MaPaFe/Drone/Arduino/AD5206_pins.jpg

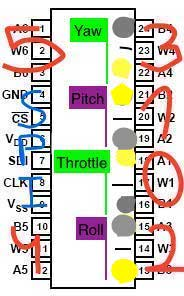
Arduino/AD5206_pins.jpg
