MaPaFe/Drone/README.md

# Drone
Programmabel drone freimwork

---

We decided to schwitch to C++ and gitlab: https://gitlab.com/MaPaFe/drone2
