MaPaFe/Drone/Langfassung 2017.pdf

## Inhaltsverzeichnis Kurzfassung

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
olle

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
alib

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
zisio

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
Digip

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
tisie

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
## Kurzfassung

Wir hatten uns eine günstige Spielzeugdrohne gekauft und nachdem wir etwas damit gespielt haben, ist uns aufgefallen, dass man deren Position ständig korrigieren muss, damit sie auf derselben Position bleibt. Wir fragten uns, ob ein Computer fähig wäre, die Kontrolle zu übernehmen und die Drohne selbstständig zu steuern. Um dies zu erreichen, mussten wir die Drohne zuerst im Raum orten, um sie dann von einem Computer aus zu kontrollieren. Die Erfassung der Drohne erreichten wir mit einer Kinect-Kamera, die nicht die Farbe eines Pixels ermittelt, sondern dessen Entfernung zur Kamera. Damit konnten wir die genaue Position der Drohne in 3 Dimensionen feststellen. Die Drohne wird mit einer kleinen Fernbedienung gesteuert, die die Position der Joysticks mittels Potentiometer misst. Um die Joysticks zu simulieren, benutzten wir einen Arduino als Steuereinheit mit einem digitalen Potentiometer. So haben wir die Drohne gesteuert, ohne die Joysticks bewegen zu müssen. Wir konnten damit die Drohne stabil in der Luft halten und gezielt Positionen im Raum anfliegen.

## Einleitung

Heutzutage sind Drohnen der Letzte Ruf, Firmen wie Amazon, Mercedes, Intel und Google investieren in Drohnenentwicklung. Doch alle haben als Ziel den Transport im Freien. Sie benutzen dafür große Drohne die viel wiegen und kraftvolle Motoren besitzen. Wir entgegen möchte eine Drohne für den Innenraum. Unser vorschlag ist einen System zu entwickeln, in dem der Raum die Drohne steuert. Der Raum soll dafür die Drohne orten können und dan . Das innovative ist hierbei, dass die Drohne nicht “denken” muss, sie hört nur “blind” zu was der Raum kommandiert. So erleichtern wir die Drohne, da diese keine Wahrnehmungstechnik tragen muss. Dass reduziert auch Strom verbrauch und steigert die Flugzeit.
Als Prototypsystem dachten wir uns die billigste Drohne zu kaufen, da diese am “blindesten” war (nur ein Sensor um waagerecht zu bleiben), und eine 3D-Kamera, die die Drohne dreidimensional orten konnte. Damit wollen wir auch zeigen, dass der System auch im schlimmstmöglichen fall funktioniert.
Es gibt Universitäten (z.B. ETH Zürich), die einen ähnlichen System benutze. Sie benutzen aber ein sehr teures VICON tracking System (mehrere zehntausende Euro). Was die ETH eigentlich forscht sind maniobrierungs Algorithmen und neue arten von Flugmaschine. Das “Endprodukt” ist nicht mit den Trackingsystem gedacht.
Dieses Projekt ist eine weiterleitung von “Externe Erweiterung der Fähigkeiten eines Spielzeugquadrokopters (Stabilisierung im Raum)”, welches wir im Wettbewerg Jugeng Forscht Iberia 2016 vorstellten.

## Materialien

Für unser Projekt brauchen wir manche Hardwarekomponenten, aber auch viele Softwarekomponenten, da es zum Teil ein Informatikprojekt ist.
Warum wir uns für genau diese Komponenten entschieden und wofür sie nötig sind, erklären wir im laufe der Arbeit.

Hardware:
Drohne: Cheerson CX-10
3D Kamera: Kinect 2
Mikrocontroller: Arduino Mega 2560 Potentiometer: AD5206
Software:
Processing
Serial Bibliothek
Blob detection Bibliothek
Kinect Bibliothek
Mac version
Windows version
Arduino
SPI Bibliothek

## Durchführung

Unser Projekt ist in zwei Teilen unterteilbar: zum Ersten müssen wir die Drohne vom Computer aus kontrollieren, aber als Zweites auch deren Position bestimmen um entscheiden zu können, wie sie sich bewegen muss.

Öffnen der Fernbedienung

Am Anfang haben wir gedacht, dass wir die Radiosignale, die von der Fernbedienung zur Drohne gesendet werden, aufnehmen können um die verschiedenen Kommandos (zum Beispiel wie stark nach vorne zu bewegen), zu verstehen um diese später beliebig selber zu senden und die Drohne damit steuern.

Als wir aber die Fernbedienung öffneten und herausfanden, dass deren Joysticks, wie in in vielen anderen Modellen auch, mit simplen Potentiometern funktioniert, dachten wir uns, dass es eine viel bessere Idee wäre, einfach diese

Potentiometer zu simulieren und so der Fernbedienung denken lassen, dass man die Joysticks physisch bewegt.

Dies erreichten wir mit hilfe eines digitalen Potentiometers. Dies ist eine Art von IC (integrated circuit) welches digitalen Signalen zu einem analogen Widerstand wandelt.

Diese Technik besitzt mehrere Vorteile, doch vor allem, dass jedes Drohne Modell höchstwahrscheinlich andere Signale für dieselben Bewegungen benutzt. In diesem Fall wäre es nötig, für jede einzelne Drohne das ganze Prozess zu wiederholen, um sie fliegen zu können, welches nicht das Ziel des Projektes ist. Außerdem ist die Messung dieser Signale auch nicht trivial, da wir spezialisierte Hardware und eine erweiterte Verständigung der Kommunikationsprotokolle bräuchten.

Die Funktionsweise eines digitalen Potentiometer sind kleine Widerstände innerhalb des Chips, die mit Transistoren in Reihe zusammengeschaltet werden, um einen größeren Widerstand zu bilden.

Wir entschieden uns für den AD5206 als digitaler Potentiometer (kurz Digipot) wegen den folgenden zwei Gründen: es ist ein einziges Chip mit 6 Digipots, womit der elektronische Schaltkreis simpler bleibt und es benutzt SPI als Kommunikationsprotokoll, weshalb es sehr einfach mit einem Mikrocontroller zu benutzen ist.

Mikrocontroller

Es fehlt nur noch ein Bauteil,der Mikrocontroller, welches die Befehle des Computers auf das Digipot weiterleitet, da der Computer selber nicht SPI “sprechen” kann. Der Mikrocontroller wird wie ein Übersetzer benutzt, dank ihm können der Computer und der Digipot kommunizieren. Als Mikrocontroller haben wir ein Arduino Mega mega ausgesucht, da dieser einfach zu programmieren ist. Arduino ist eine open source Hardware/Software initiative, die die Vereinfachung der Benutzung Mikrocontroller strebt. Der Arduino Mega spricht mit den Computer durch einen internen seriellen Port durch eine USB verbindung. Der Arduino kann nicht nur SPI, es kann auch programmiert werden. Darum benutzen wir es auch um die Verbindung mit der Drohne zu automatisieren (wird später aufgegriffen).

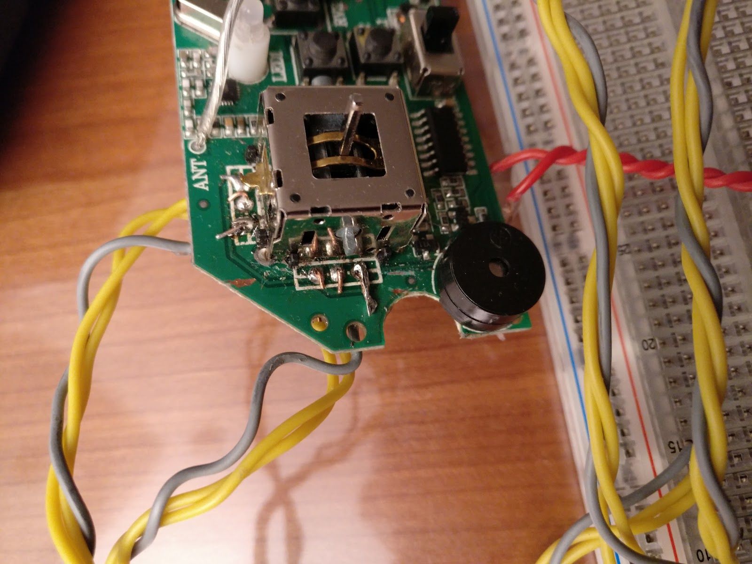
[picture p2: figure]

Um die Fernbedienung zu dem Digipot anzuschließen mussten wir zuerst die “normalen” Potentiometer auslöten. Es stellte sich heraus, dass der benutzte Lötzinn ein industrieller war und sich deshalb von unseren einfachen Lötkolbe in der Schule nicht löten ließen, weshalb wir die Joysticks rausreißen mussten.

Danach mussten wir nur noch drei Kabel per Potentiometer von der Fernbedienung zum Digipot und diesen wiederum zum Arduino verbinden.

Jetzt kann der Computer beliebig die Drohne steuern, aber damit sie sich komplett autonom bewegen kann, muss der Computer auch wissen, wo die Drohne ist um die gewünschten Anweisungen für die Fernbedienung zu rechnen.

Kinect

Als erstes brauchten wir eine 3D-Kamera, das ist eine Kamera die anstatt die Farbe von einem Pixel messen kann, die Distanz zu diesem Punkt ermittelt. Wir brauchen so eine Kamera um wissen zu können, wo genau sich die Drohne im 3D-Raum befindet. Außerdem ist es damit im Gegensatz zu einer “normalen” Farbkamera einfacher den Quadrokopter vom Hintergrund zu differenzieren.Wir entschieden uns unter den vielen Modellen für die Kinect für mehrere Gründe. Es ist mit 170€ eine der günstigsten Kameras überhaupt und hat eine sehr präzise theoretische Auflösung von 2 Millimetern in der Tiefe.Die Kinect wurde eigentlich von Microsoft für die XBOX Spielkonsolen entwickelt, kann aber mit einigen Adapterkabeln auch mit einem Computer benutzt werden.
Die Funktionsweise der Kinect ist ähnlich eines radar system, doch anstatt niedrige Frequenz Photonen benutzt es hoch Frequenz Photonen, also Licht. Darum werden Kameras, die mit diesem Prinzip funktionieren, auch LIDAR genannt (light-radar). Als Sendere werden drei infrarot Leds benutzt und als Empfänger wird ein spezieller Time-of-flight (Tof) sensor eingesetzt. Dieser misst die Zeitverschiebung zwischen dem Senden und Empfangen mithilfe spezieller Pixels. Mit dieser Zeitverschiebung kann die Distanz berechnet werden, dar
c = | t , die halbierung der Zeit ist nötig, da | eigentlich die kombinierte

l
t
2

1 ⇒ l = c * 2

1
t | t

identische Hin- und Zurückzeit ist. Das gesendete Signal ist Licht und bewegt sich darum mit Lichtgeschwindigkeit c = 299 792 458 m .
Der Sensor wurde von Microsoft selbst entwickelt und besitzt ein Auflösung von 512 mal 424 pixel (0,217 Megapixel). Der Sensor kann auch per Pixel den Infrarot Umgebungslicht des Raumes, die der Sonnenlicht enthält, berücksichtigen. Die reichweite des sensors ist von den Leds limitiert, diese bieten aber dafür einen breiten Beleuchtungsraum.

Datenerfassung

Die Kinect gib aus Output einen eindimensionalen Array d i die die Distanzen in Millimetern enthält. Obwohl der Sensor eigentlich bidimensional ist werden die Daten in ein einzigen Array gefasst, da dieses effizienter ist. Durch der benutzung dieser Speichermethode verliert sich aber die Intuition eines bidimensionalen Array in den zwei Indexen die Position des Pixel Bestimmen. Doch die eindimensionaler Array ist eigentlich nur die aneinanderreihung der Zeilen

des Sensors: di = dzeile 1 + dzeile 2 + ... + dzeilen n

. Mit hilfe der Formel di,j | kann sie als eine

bi. = d

uni.
i+B j *
bidimensionale gelesen werden. Hierbei ist i und j die zwei indexe und B der máximaler i

Wert. Im falle der Kinect würde i die X-Achse des Sensors sein, j die Y-Achse und B würde den Wert 512 entsprechen.

Pespektivkorrektur

Jetzt muss man aber bedenken, dass die Kinect eine Kamera ist und darum seine Daten Perspektive beinhalten. Um diese Perspektive zurückzurechnen benutzt man den
Punktkamerapespektivenmomdell (Fig.1): (− p | ) | . Hierbei ist | der

p
x,y − Mx,y = p
r
z

f x,y
* p

r
x,y | p

p
projektierter Punkt auf der Projektionsebene (Sensor), p der reelle Punkt im Raum, ist die

r
f x,y
Brennweite und Mx,y die optische Mitte.

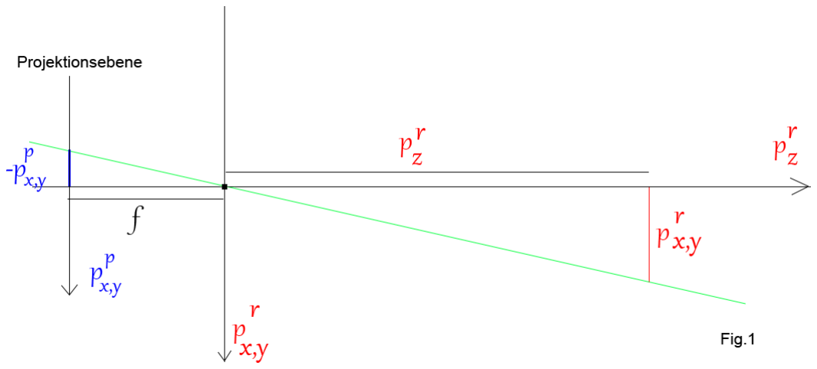
[picture p3: figure]

In einer normalen kamera ist p bekannt aber | nicht. Dies ist so dar | und | unbekannt sind
p | p
r | pz | p

r
x,y
( f x,y

ist eine optische eigenschaft der kamera, mathematisch gesehen eine Konstante). Doch in
der Kinect ist p bekannt und | kann mit einfachen umformen mit der Formel
z | p

r
x,y
(− p | ) | berechnet werden.

p
x,y − Mx,y *

p

r
z
f x,y

= p

r
x,y

Kalibrierung

Ein wichtiger Aspekt wenn man mit Kameras arbeitet ist ihre Kalibrierung. Dabei werden die Brennweite f und die optische Mitte des Sensors gesucht. Wir benutzten den Programm GML C++ Camera Calibration Toolbox (http://graphics.cs.msu.ru/en/node/909) von der Graphics and Media Lab an der Staatlichen Universität Lomonosov in Moskau. Das programm nimmt Fotos von Kalibrierungsmustern und berechnet von ihnen die nötige Parametern. Unsere Gab für die Brennweite f x = 364.18 f y = 364.33 und für die
optische Mitte ergab sich die geometrische Mitte also Mx,y = | ( | ist 2
maxx,y | max
der Maximalwert für x oder y , also die breite und höhe des sensors).

Präzision der Kinect

Wie schon erwähnt wurde, misst die Kinect Distanzen durch reflexion von Licht. Das führt manchmal zu Fehlmessungen in reflektiven gegenstände, da das Licht nur dann gelesen werden wenn es den Sensor auch erreicht. Ein anderer problem sind dunkle Gegenstände, da diese Photonen teilweise absorbieren. Das hat zur folge, dass weniger Photonen den Sensor erreichen und die messung mehr Rauschen enthält. Noch ein Problem ist die Lichtquelle die den Raum nicht gleichmäßig beleuchtet und bestrahlen den Bildrand kaum. Wir haben auch die durchschnittliche Abweichung jedes Pixel berechnet. Dafür haben wir den für jeden Pixel d ,
i | n
Messungen durchgeführt und in di gespeichert. Mit der Forme | kann
j

### di = n

1
* ∑

n

j=1

d d

i
j

− m i

dann die durchschnittliche Abweichung berechnet werden. Wobei der durchschnitt des Pixel
md mit der Formel | bestimmt wird. Der Resultat kann in einem Foto dan i | mdi = n

1
* ∑

n

j=1

di
j
visualisiert werden. Hierbei ist : orange ≈ 1,27mm,
gelb ≈ 2,8mm,
grün ≈ 5 mm,
blau ≈ 10mm und
rot ≈ 16mm.
Ab 16mm sind die Pixels Schwarz gezeigt. Die Ränder aber besonder die Ecken haben ein sehr hoher Rauschen. Die größte Fläche hat aber ein geringes rauschen mit nur 1.3mm Abweichung.

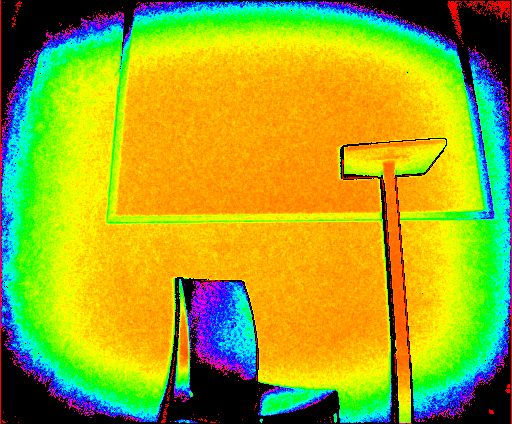
[picture p4: figure]

Programmierumgebung

Als Programmierumgebung entschieden wir uns für Processing, eine auf Java basierte Sprache die für uns die meisten Vorteile hat. Wir haben bereits mehrere Jahre damit Erfahrung und sie besitzt die nötige Bibliotheken für die serielle Kommunikation mit Arduino und die Kommunikation mit der Kinect. Es ist außerdem open-source und cross-platform, was heisst, dass es auf jedem Operativsystem funktioniert.
Die Entfernungswerte der Kinect werden mithilfe einer Bibliothek erfasst. Diese Bibliothek ist jedoch für Mac und Windows eine andere, deshalb während die Methodenname im Programm anders weshalb wir den gleichen Code nicht in verschiedenen Computern benutzen könnten. Um dies zu tun, schrieben wir zwei Wrapper-Klassen, eine für jede Plattform, die die gleichen Methodennamen benutzt, damit der Programmiercode austauschbar ist. Außerdem schrieben wir noch eine dieser Klassen, die ein vorher aufgenommenes Video von der Kinect abspielt, damit wir Programme austesten können, wenn wir nicht die Kinect dabei haben oder die physische Umgebung nicht die richtige ist.
Die eigentliche Erfassung der Position funktioniert in mehreren Schritten, es benutzt also verschiedene Algorithmen je nach Zustand des Programmes.

Finden der Drohne

Am Anfang, wenn die Drohne noch nicht gefunden wurde wird das die Drohne mit des sogenannten Mindestabstand erfasst. Mit dieser Methode wird alles, was näher als ein vorbestimmter Wert ist, als Drohne erkannt. Diese Mindestdistanz muss klein genug sein, dass der Hintergrund nicht erfasst wird und für die Drohne verwechselt wird. Die Drohne wird näher zur Kamera gebracht, bis sie vom System erkannt wird und mit diesem Erstwert zu der nächsten Erkennungsmethode schreitet.

Blob detection

Blob detection (BD) ist ein Algorithmus im Bereich des computer vision welches Gruppen von Pixeln in einem Foto, die zum selben Objekt gehören erkennen kann. Dies funktioniert in einem üblichen Farbbild indem man alle Pixel die eine ähnliche Farbe haben und nah zueinander sind zusammen gruppiert.

Finden am Anfang

Wir können diese Methode benutzen um die Position der Drohne im Bild der Kinect zu finden. Dafür erstellen wir ein eigenes Bild mit weißem Hintergrund auf welches wir nur die Pixel färben, die Teil der Drohne sein könnten um auf dieses Bild BD auszuführen und die mittlere Position der Drohne zu bestimmen. In dem ersten Teil unseres Systems wären diese gefärbten Pixel genau die, deren Distanz zur Kamera kleiner als ein bestimmter Wert ist.
Um die Drohne danach weiter lokalisieren zu können, benutzen wir eine Reihe verschiedener Algorithmen, unter anderem auch unser selbstentwickeltes Box-tracking.

Box-tracking

Um den aktuelle Standort der Drohne zu bestimmen, berechnen wir zuerst die vorhergesehene nächste Position mithilfe der vorherigen zwei. Wir subtrahieren also die vorletzte Position von der letzten um die Geschwindigkeit zu bekommen und addieren diese letztendlich zur letzten Position. Jetzt haben wir eine Vorhersage von dem Ort, an dem sich die Drohne höchstwahrscheinlich befindet, welche dem Box-tracking als input gegeben wird.
Wie dieses Algorithmus funktioniert, kann man sich einfach vorstellen: Um die Vorhersage, also den Punkt im dreidimensionalen Raum, zeichnet man eine Kiste, und alle Objekte, die sich innerhalb dieser Kiste befinden, werden als Drohne erkannt. Ist in dieser Kiste gar nichts zu

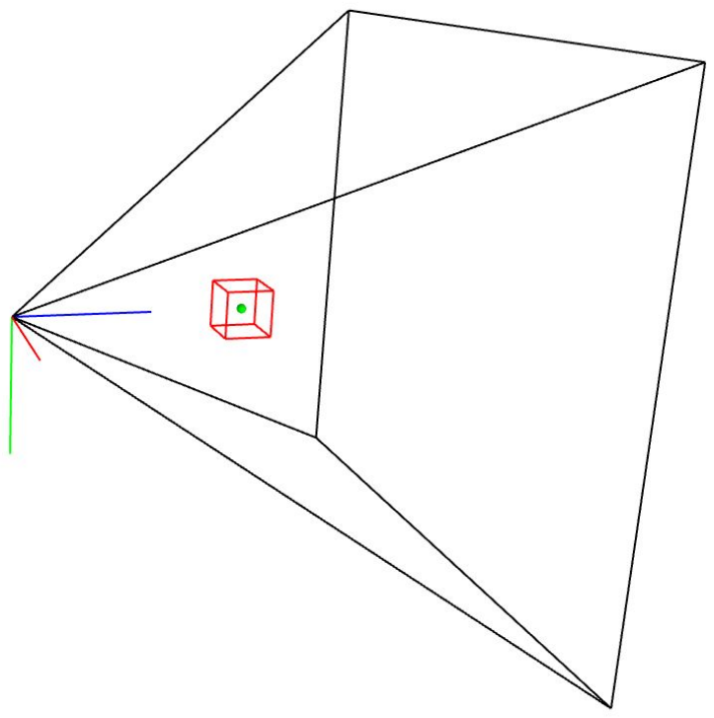
[picture p5: figure]

finden, wird deren Größe ein Stück erweitert, und das solange bis etwas gefunden wurde oder sie zu groß ist, in diesem Fall wird die Drohne als verloren angesehen und es wird von neuem angefangen.
In der Praxis wird nur über die Werte im Array der Kinect iterieriert, die sich in der Kiste befinden, und davon werden nur die Werte, die in der z-Achse auch innerhalb der Kiste sind, auf das neue Bild für das BD übertragen.
Nun können wir zuverlässigerweise die Drohne im Raum orten, doch um sie zu steuern, müssen wir auch berechnen, wie sich die Joysticks bewegen müssen, damit die Drohne zu dem gewünschten Punkt fliegt.

Berechnung der Potentiometer

Um dies zu erreichen, benutzen wir einen sogenannten PID-Regler. Das ist ein Algorithmus für die Regelung von Werten, die man nicht direkt ändern kann und vielleicht Störungen von außen haben (z.B. Wind, Stöße). Eine Praktische Anwendung dafür wäre ein autonomes Fahrzeug, welches das Gaspedal des Autos steuern (also die Beschleunigung v ) kann, aber nicht die genaue Position (s). Deshalb muss es die Beschleunigung immer weiter ändert bis die aktuelle Position der gewünschten (Setpoint) entspricht.Für unsere Drohne hat jede Achse einen eigenen PID, welcher mit der aktuellen Position der Drohne und dem Setpoint informiert wird und den Widerstandswert für den Digipot berechnet.
Der PID Reglungsalgorithmus besteht aus drei verschiedene Teile, die versuchen ein Fehler zu minimieren. Das P teil steht für Proportional zum Fehler, I für die Integral des Fehlers mit der

Zeit und D für Derivativ (in deutsch Ableitung), die momentane änderung des Fehlers. Diese Teile werden zusammen addiert und die resultierende Summe ist die die nötige Korrektur. Hierbei ist jeder Teil gewichtet um mehr oder weniger anteil in der finalen Summe zu haben. Die

PID Formel lautet PID = Kp * F(t) + K | (t) dt | . Mit den Gewichten | , , | .

i * ∫

t

0

| F + Kd * dt
dF(t) | Kp Ki Kd

Bei der Implementation ist die berechnung des PIDs einfach, dar der proportionale Teil eine einfache Multiplikation ist, der Integrale Teil ist eine Variable die den Fehler addiert bekommt und so den kumulativen Fehler beinhaltet und Derivative Teil ist die differenz des Letzten Wertes und den neusten.
Das komplizierte an den PID sind die korrekte Gewichten zu finden. Diese sind nur experimentell zu bestimmen. Das hat uns viel Zeit gekostet, da bei einer Drohne alle drei PIDs gleichzeitig bestimmt werden müssen.

Processing zu Arduino

Um die berechneten Werte letztendlich wieder zur Fernbedienung über zu senden, kommunizieren wir zuerst mit dem Arduino mit dem seriellen Port über USB. Es gibt für Processing eine leicht zu benutzende Bibliothek, die fast alles automatisch macht. Da alles im Processing-programm berechnet wird, werden nur die endgültigen Werte, die auf den Digipot weitergeleitet werden, gesendet. Diese Werte sind ein Array mit vier Variablen des Typs byte, da die Potentiometer nur 255 verschiedene Positionen haben können. Wir versuchen die kleinste Anzahl an Daten zu senden damit sie schneller übertragen werden.
Im Arduino wird dieses Array empfangen und die Werte einfach auf den Digipot kopiert. Danach wird ein einziges byte zurückgesendet welches Processing wissen lässt, dass der Arduino bereit ist, die nächsten Werte zu empfangen.

Arduino zu Digipot

Die Kommunikation mit dem Digipot wird mit SPI realisiert. SPI ist ein Kommunikationsprotokoll, welches mit nur drei Kabeln funktioniert und mehrere verschiedene Endgeräte (in unserem Fall mehrere digitale Potentiometer), auch als “Sklaven” bezeichnet, auf einmal unterstützt, welches für uns nützlich ist wenn wir mehrere Drohnen fliegen wollen, weil wir einfach ein zweites Digipot anschließen müssen und schon funktioniert. Um mit dem AD5206 einen Widerstand zu stellen stellt man den “Sklavenauswahlpin” auf 0 Volt, um dem Protokoll wissen zu lassen, an welches der Sklaven die Werte zu senden sind. Mit unserem aktuellen Aufbau gibt es nur ein Digipot, aber dieser Schritt ist wichtig, wenn man mit mehreren Sklaven arbeitet. Danach werden mit der SPI Bibliothek zwei Werte gesendet (mit einem

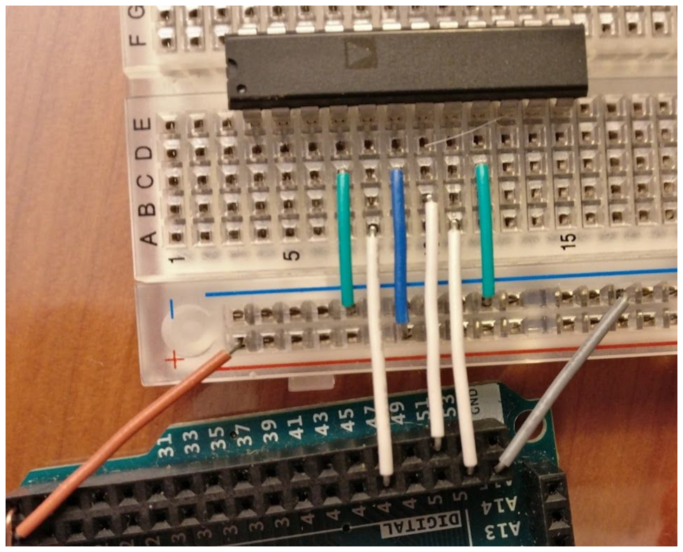
[picture p6: figure]

anderen Modell als der AD5206 funktioniert dieser Schritt vielleicht anders): zuerst eine Zahl von 0 - 5, welches den einzelnen simulierten Potentiometer (da es im selben Chip sechs gibt)

auswählt und danach den Widerstandswert von 0 - 255 welcher dieser Potentiometer haben sollte. Dieser Wert wird dann auf Ohm umgewandelt, in unserem Fall also von 0 Ω - 10k Ω .

Automatisierung der Verbindung

Nach mehreren Flügen ist uns aufgefallen, wie zeitverschwendend es ist, die Drohne am Anfang mit der Fernbedienung zu verbinden, denn um das zu tun, muss man den linken Joystick zuerst ganz nach unten bewegen, dann ganz nach oben und zuletzt wieder nach unten. Das wird “Arming” genannt.
Dies ist dafür gedacht, dass die Fernbedienung weiß, welche die Maximal- und Minimalwerte dieses Joysticks sind,also sich eicheln.
Nach jedem dieser Schritte piepst ein kleiner Lautsprecher und wir dachten uns, dass wir diesen ganzen Prozess automatisieren könnten indem der Arduino sozusagen “hört” wann es piepst und entsprechend dazu die ausgehenden Werte anpasst, damit es nur noch nötig ist, Arduino, Fernbedienung und Drohne einzuschalten und das “Arming” automatisch vorgeht.

Dafür mussten wir noch ein Kabel von dem Piepser zum Arduino löten, der dann die Stromspannung misst und damit, ob der Piepser gerade an ist oder nicht.

Open-source

Alle unsere geschriebenen Programme sind open source und auf GitHub unter der Adresse https://github.com/MaPaFe/Drone erhältlich. Es ist mit der Mozilla Public License 2.0 lizensiert, was heisst, das jeder erlaubt ist, den Code zu sehen und sogar selbst zu benutzen und erweitern, solange wir dafür Anerkennung bekommen und Patentrechte behalten.

Messungen

Um unser System zu werten brauchen wir Messungen zu machen. Eine erste, logische, Messung ist die Drohne auf einen Punkt im Raum Kommandieren und n Messungen der echten Drohn Position durchführen. Nun kann man die durchschnittliche Abweichung rechnen:
ax = | . Wobei die rechnung für jede Achse separat geführt wird und | die Achse n

1
* ∑

n

i=1

x

i − mx

x

bezeichnet und mx der durchschnitt der Werte ( mx = | ). Nun hat man einen Wert für jede n

1
* ∑

n

i=1

xi

Achse, den man mit anderen Systeme vergleichen kann. Man kann dann auch den wert der drei Achsen in einem zusammenfassen: as = . Diese Rechnung kann mit ein bisschen 3

ax+ay+az
modifikation auch um die genauigkeit der Drohne beim Pfad Folgen benutzt werden. Anstatt den wert gegen den der Durchschnitt zu vergleichen, wird er gegen die theoretisch korrekte
Position vergleicht: ax = | . Bedenkt werden ist, dass beim generieren der korrekten n

1
* ∑

n

i=1

x

i − Ti

positionen T auch die geschwindichkeit geprägt wird. Dadurch kann auch die geschwindichkeit
i
gegen Präzision untersucht werden um die optimale geschwindigkeit zu suchen.

## Mögliche Anwendung

Wir wollten dieses System bauen, um die Drohne von einem aus Computer kontrollierbar zu machen und so zu automatisieren.
Dies könnte industrielle Anwendungen haben wie zum Beispiel im Gütertransport in Innenräumen. Wie kann eine Firma eine Drohne als Transportmittel im selben Firmengebäude benutzen, um z.B. Schrauben zu transportieren und dafür nicht ein eigenes Fließband bauen zu müssen? Eine Drohne könnte diese Arbeit verrichten. Sie kann mit sehr wenig Aufwand neue Wege gehen und flexibel neue Aufgaben verrichten.
Doch Drohnen haben ein Nachteil, sie können nur entsprechend ihrer Größe Nutzlast transportieren. Größere und darum schwere Drohnen könnten zu Problemen führen, da sie sehr unkontrolliert und in geschlossenen Räumen fliegen und große Motoren starke Turbulenzen erzeugen. Darum sollte eine indoor-Drohne klein sein und wenig wiegen. Da kommt unser System ins Spiel. Es macht die Drohne sehr leicht, weil die Wahrnehmungssensoren nicht von der Drohne selber getragen werden müssen. So können Drohnen ihre Motorkraft benutzen um die Nutzlast zu tragen, anstatt der zusätzlichen Sensoren.
Man muss auch berücksichtigen, dass die Sensoren und die Datenverarbeitung Energie verbrauchen und damit die Flugzeit verkürzen würden und um diese zu halten müsste man eine größere Batterie benutzen, die wiederum die Drohne schwerer mache würde und sie bräuchte dann stärkere Motoren. Diese wiegen mehr und verbrauchen mehr Strom und man braucht ebenfalls eine größere Batterie. Dieses Prozesse können einfach mit unserem System gestoppt werden.
Das System hat auch Vorteile beim hochskalieren, da die externen Sensoren für mehrere Drohnen genutzt werden können. Dies würde ebenfalls die Kosten vermindern. Je mehr Drohnen man kauft, umso besser ist das Preis-/Leistungsverhältnis des Systems.

## Pläne für die Zukunft

Wir haben viele geplante möglichen Erweiterungen für die Zukunft geplant. Als Erstes würden wir weiter die PIDs kalibrieren, damit die Drohne stabiler fliegt.
Darüber hinaus wäre es dank unser Box-tracking keine große Herausforderung, zwei oder mehr Drohnen gleichzeitig fliegen zu lassen. Danach könnten wir mehrere Kinect Kameras anschließen, um ein größeres Sichtfeld zu haben auf dem mehr und größere Drohnen passen würden.
Eine Limitierung von unserem Aufbau ist, dass die Drohne in einer bestimmten Ausrichtung sein muss, um zu funktionieren: nach vorne. Wenn die Drohne aber z.B. 90º nach rechts gedreht ist und den Befehl bekommt, sich nach vorne zu bewegen, würde sie nach rechts gehen, die PID-Regler versuchen diese Abweichung zu korrigieren, aber dies macht sie nur größer. Wir könnten einen Algorithmus schreiben, welches diese Drehung erkennt und korrigiert.

## Quellen

Arduino Mega 2560 datasheet 6.11.17
https://store.arduino.cc/arduino-mega-2560-rev3
AD5206 datasheet 6.11.17
http://www.analog.com/en/products/digital-to-analog-converters/digital-potentiometers/ad5206.h tml (http://www.analog.com/en/products/digital-to-analog-converters/digital-potentiometers/ad5206.html)

Processing homepage 7.11.17
https://www.processing.org/
Serial Bibliothek Referenz 8.11.17 https://www.processing.org/reference/libraries/serial/ Blob detection Bibliothek Referenz 8.11.17 http://www.v3ga.net/processing/BlobDetection/ Kinect Bibliothek für Mac Tutorial 7.11.17 http://shiffman.net/p5/kinect/
Kinect Bibliothek für Mac Quellcode 7.11.17 https://github.com/shiffman/OpenKinect-for-Processing Kinect Bibliothek für Windows Referenz 8.11.17 http://codigogenerativo.com/kinectpv2/
Arduino homepage 6.11.17
https://www.arduino.cc/
Arduino SPI Bibliothek Referenz 6.11.17 https://www.arduino.cc/en/Reference/SPI

Kinect offizielle Dokumentation 12.11.17 ttps://msdn.microsoft.com/en-us/library/windowspreview.kinect.depthframe.aspx
Kinect Perspektivkorrektur Tutorial 11.11.17 https://threeconstants.wordpress.com/2014/11/21/kinect-point-cloud-normals-rendering-part-1/ Punktkamerapespektivenmomdell 11..11.17 https://en.wikipedia.org/wiki/Pinhole_camera_model
Kinect Kalibrationssoftware 11.11.17
http://graphics.cs.msu.ru/en/node/909

MIT PID erklärungsvideo 5.11.17 https://www.youtube.com/watch?v=4Y7zG48uHRo Wikipedia PID 5.11.17
https://de.wikipedia.org/wiki/Regler#PID-Regler
