MaPaFe/Drone/Arduino/Buzzer_at_startup.png

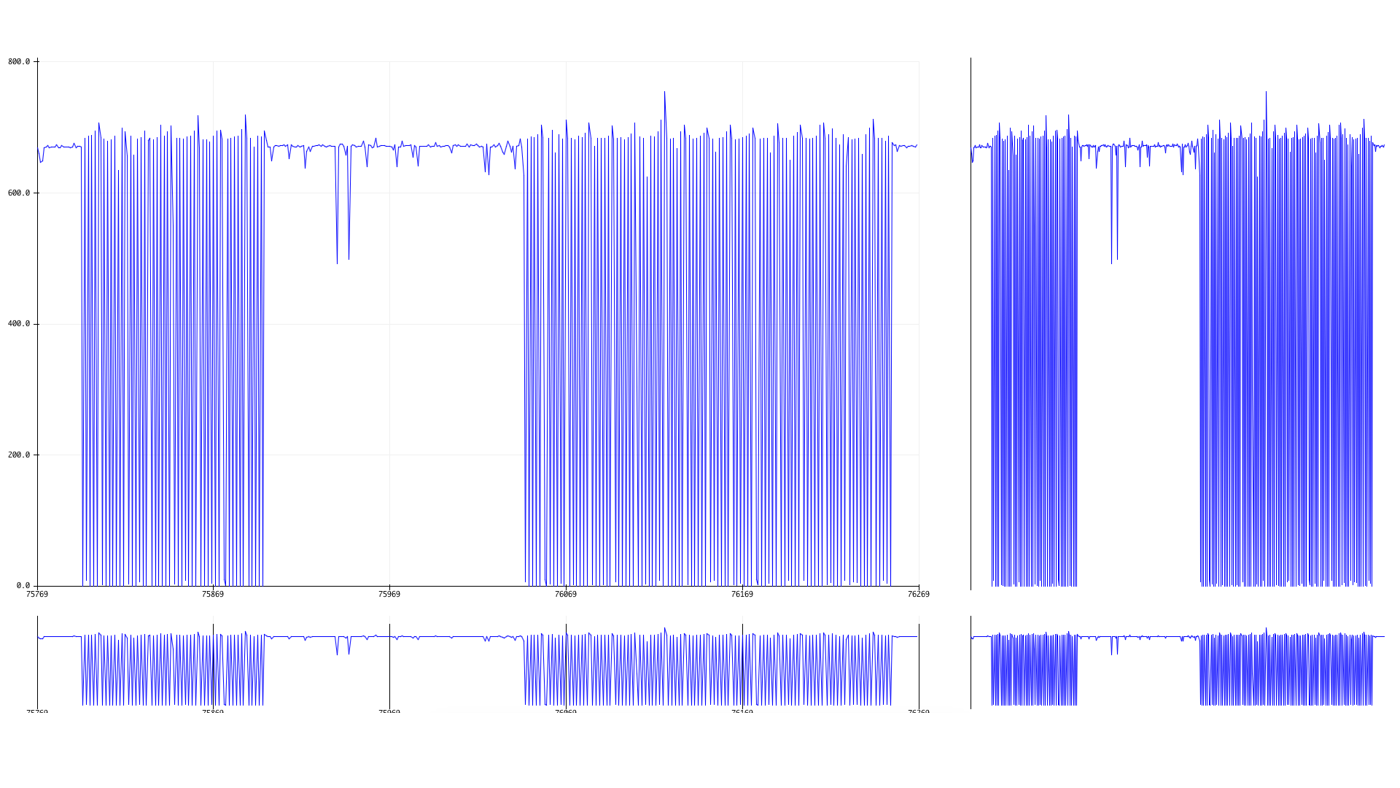
Arduino/Buzzer_at_startup.png
