MaPaFe/Drone/(threads)

Thread 5 (2017-11-13):

bad idea init with 0

Pablofero, 2017-11-13:
https://github.com/MaPaFe/Drone/blob/5e214922aa305bb6df3c013e0edcefeda2c2c0bf/Processing/PIDfirst/PID.pde#L15
it will give a enormus derivativ error!

Closed 2021-07-11.
