MaPaFe/Drone/Processing/Record/Load/Offline.pde

class Knct {
  BufferedReader reader;
  int width, height;

  Knct(PApplet pa) {
    frameRate(30);
    reader = createReader("data.txt");

    width = 512;
    height = 424;
  }

  int[] getDepth() {
    try {
      return int(split(reader.readLine(), ","));
    } 
    catch (IOException e) {
      int[] shit = {};
      exit();
      return shit;
    }
    catch (NullPointerException e) {
      int[] shit = {};
      exit();
      return shit;
    }
  }

  PImage getImage() {
    PImage out = createImage(width, height, RGB);
    int[] frame = getDepth();
    out.loadPixels();
    for (int i = 0; i < frame.length; i++) out.pixels[i] = color(map(frame[i], 0, 4096, 0, 255));
    out.updatePixels();
    return out;
  }
}
