MaPaFe/Drone/(commit log)

2017-04-19 Stable framerate
2017-04-22 added prueba que lee data.txt y utiliza libreria blob
2017-04-26 New Transmitter thing shit not working
    [Transmitter4.ino]
2017-05-03 añadido test para probar comunicación mando-arduino
2017-06-03 Program flowchart
2017-06-21 Fix some little Arduino stuff
    [Axis4.ino, Axis4.pde, DigitalPotControl.ino]
2017-06-21 Fixed depth calculation + uses average instead of single point
    [Drone.pde]
2017-07-08 New Camera lib
2017-08-08 added noise calculation for kinect
    [Noise.pde, Noise_kinect_calc.pde]
2017-09-02 correct focal distance after calibration
    [FormulasKinect.pde, Kinect_visualization.pde]
2017-10-21 New Arduino test
2017-11-14 Autoconnect to remote control with buzzer information
    [Communication.ino]
2017-11-14 New pin diagrams
2018-02-03 Corrected fucking huge shit mistake of pid integral
    [PID.pde]
2018-02-03 Corrected fucking huge shit mistake of pid integral,forgot that one
    [PID.pde]
2018-05-22 New graphs for PID outputs Graph stop when not flying Only fly when pressing space instead of the other way around
